Engineering-3/VAR-PBB/DC-DC.jpg

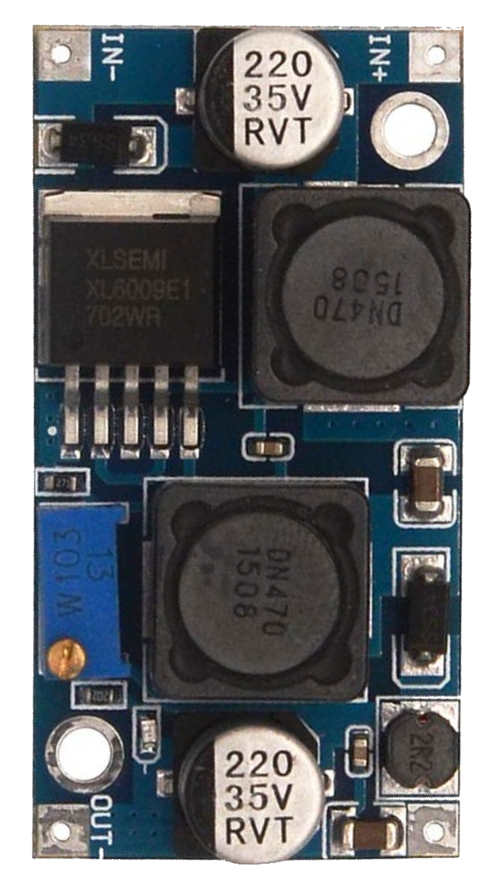
DC-DC.jpg
