Engineering-3/VAR-PBB/README.md

# VAR-PBB
Power Bus Board, but for variable uses
