Engineering-3/VAR-PBB/VAR-PBB_v02/README - VAR-PBB PCB Specification.txt

RCM-PBB-E1 PCB Specification
-------------------------------

BOARD STACK:

1. Copper Top
2. Copper Bottom

SILKSCREENS:

1.  Both Layers

PASTE MASKS:

1. Top Layer

BOARD MATERIALS:

RoHS Compliant: YES
Copper: 2oz  ************************************
Finish: Immersion Gold
Material: FR-406
Thickness: 62 mil
Tg>170
Soldermask: SMOBC BLUE
Silkscreen: White

BOARD TESTING:

Electrical Test: YES
