Engineering-3/VAR-PBB/VAR-PBB_v02/VAR-PBB_v02_render_top.png

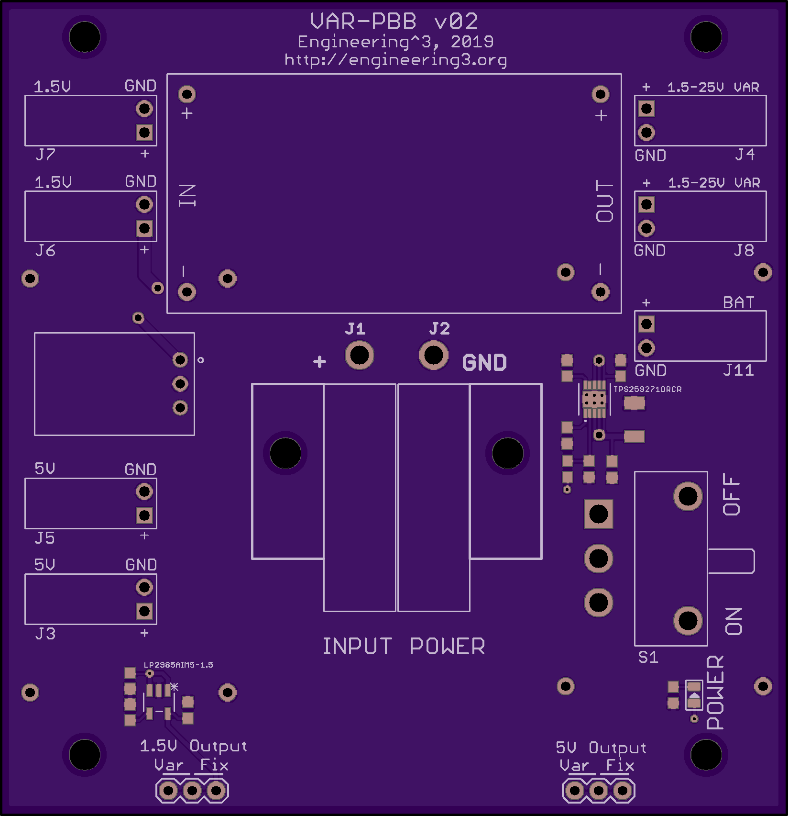
VAR-PBB_v02/VAR-PBB_v02_render_top.png
