Engineering-3/VAR-PBB/VAR-PBB_v02/VAR-PBB_v02_BOM.xlsx

Sheet: Bus Board RCM R05
VAR-PBB | Rev 02
Schmalz Haus LLC
Brian Schmalz - brian@schmalzhaus.com
Reference Designator | Value | MFR | MFR Part Number | Digikey Part Number | Qty | Description | Notes
U1 |  | Murata Power Solutions Inc. | OKI-78SR-5/1.5-W36H-C | 811-2692-ND | 1 | Linear Regulator Replacement DC DC Converter 1 Output 5V 1.5A 7V - 36V Input | 5V fixed DC-DC switching regulator, right angle style
U5 |  | Texas Instruments | LP2985AIM5-1.5/NOPB | LP2985AIM5-1.5/NOPBCT-ND | 1 | Linear Voltage Regulator IC 1 Output 150mA SOT-23-5 | 1.5V linear low dropout regulator, SOT-23-5
D2 |  | Visual Communications Company - VCC | CMD17-21SRC/TR8 | L62411CT-ND | 1 | Red LED Indication - Discrete 1.7V 0805 (2012 Metric) | Super bright red LED 0805
U6 |  | Texas Instruments | TPS259271DRCR | 296-44973-1-ND | 1 | Electronic Fuse Regulator 5A 10-VSON (3x3) | E-fuse, UVLO and over-current cutout
U2 |  | Amazon | XL6009 DC to DC |  | 1 |  | https://www.amazon.com/gp/product/B07NTXSJHB/ref=ppx_yo_dt_b_asin_title_o09_s00?ie=UTF8&psc=1
J1 |  | Anderson Power Products, Inc. | 1327 | 2243-1327-ND | 1 | 1 Position Blade Type Power Housing Connector Non-Gendered Red | Battery input power connector, RED
J2 |  | Anderson Power Products, Inc. | 1327G6-BK | 2243-1327G6-BK-ND | 1 | 1 Position Blade Type Power Housing Connector Non-Gendered Black | Battery input power connector, BLACK
 |  | Anderson Power Products, Inc. | 1399G8-BK | 2243-1399G8-BK-ND | 2 | PP10/45 MOUNTING WING BLUE | Power pole blue wings
 |  | Anderson Power Products, Inc. | 1377G4-BK | 2243-1377G4-BK-ND | 2 | Blade Contact Solder, PCB Non-Gendered Tin | Anderson power connector straight pins
S1 |  | E-Switch | 500SSP1S1M6QEA | EG2478-ND | 1 | Slide Switch SPDT Through Hole, Right Angle | Power slide switch
C6 |  | KEMET | C1210C226K4PACTU | 399-5092-1-ND | 1 | 22µF ±10% 16V Ceramic Capacitor X5R 1210 (3225 Metric) | 22uF 1210 16V ceramic cap
C2, C4, C5 |  | Murata Electronics | GRT188C8YA105KE13D | 490-12297-1-ND | 2 | 1µF ±10% 35V Ceramic Capacitor X6S 0603 (1608 Metric) | 1uF 0603 >30V ceramic cap
R3 |  | Stackpole Electronics Inc | RMCF0603FT45K3 | RMCF0603FT45K3CT-ND | 1 | 45.3 kOhms ±1% 0.1W, 1/10W Chip Resistor 0603 (1608 Metric) Automotive AEC-Q200 Thick Film | 45.3K 1% 0603 resistor
R5 |  | Stackpole Electronics Inc | RMCF0603FG1M00 | RMCF0603FG1M00CT-ND | 1 | 1 MOhms ±1% 0.1W, 1/10W Chip Resistor 0603 (1608 Metric) Automotive AEC-Q200 Thick Film | 1M 1% 0603 resistor
R6 |  | Stackpole Electronics Inc | RMCF0603FT210K | RMCF0603FT210KCT-ND | 1 | 210 kOhms ±1% 0.1W, 1/10W Chip Resistor 0603 (1608 Metric) Automotive AEC-Q200 Thick Film | 210K 1% 0603 resistor
R4 |  | Stackpole Electronics Inc | RNCP0603FTD392R | RNCP0603FTD392RCT-ND | 1 | 392 Ohms ±1% 0.125W, 1/8W Chip Resistor 0603 (1608 Metric) Anti-Sulfur, Moisture Resistant Thin Film | 392 ohm 0603 resistor
J11, J8, J4, J3, J5 J6, J7 |  | Molex | 70553-0036 | WM4924-ND | 7 | Connector Header Through Hole, Right Angle 2 position 0.100" (2.54mm) | 2-pin polarized power output connectors
C1 |  | KEMET | C0603C104M5RACTU | 399-7845-1-ND | 1 | 0.1µF ±20% 50V Ceramic Capacitor X7R 0603 (1608 Metric) | .1uF 0603 cap
C3 |  | Murata Electronics | GRM188R6YA225MA12D | 490-10486-1-ND | 1 | 2.2µF ±20% 35V Ceramic Capacitor X5R 0603 (1608 Metric) | 2.2uF 0603 cap
J9, J10 |  | Adam Tech | PH1-03-UA | 2057-PH1-03-UA-ND | 2 | Connector Header Through Hole 3 position 0.100" (2.54mm) | 3-pin 0.1" male headers
JMP1, JMP2 |  | Sullins Connector Solutions | SPC02SYAN | S9001-ND | 2 | 2 (1 x 2) Position Shunt Connector Black Closed Top 0.100" (2.54mm) Gold | 2-pin 0.1" jumper shorting blocks
DO NOT POPULATE
C7 |  |  |  |  |  |  | Unknown value 0603 ceramic cap
U3, U4 |  | Amazon | XL6009 DC to DC |  | 2 |  | https://www.amazon.com/gp/product/B07NTXSJHB/ref=ppx_yo_dt_b_asin_title_o09_s00?ie=UTF8&psc=1

Sheet: Sheet2
Partlist
Exported | from Bus_Board_RCM_R05.s | ch at 5/5/2012 10:58:37 | AM
EAGLE Ver | sion 5.11.0 Copyright (c | ) 1988-2010 CadSoft
Part | Value | Device | Package
R14 | 0 | RESISTOR | 805
R34 | 0 | RESISTOR | 805
R42 | 0 | RESISTOR | 805
R50 | 0 | RESISTOR | 805
R3 | 0.033 | R-US_R2010 | R2010
R26 | 0.033 | R-US_R2010 | R2010
R36 | 0.033 | R-US_R2010 | R2010
R44 | 0.033 | R-US_R2010 | R2010
R25 | 22 | RESISTOR | 805
R29 | 22 | RESISTOR | 805
R17 | 25 | RESISTOR | 805
R1 | 100 | RESISTOR | 805
R8 | 100 | RESISTOR | 805
R19 | 499 | RESISTOR | 805
C1 | 0.1u | CAP0805 | 805
C3 | 0.1u | CAP0805 | 805
C5 | 0.1u | CAP0805 | 805
C6 | 0.1u | CAP0805 | 805
C7 | 0.1u | CAP0805 | 805
C8 | 0.1u | CAP0805 | 805
C9 | 0.1u | CAP0805 | 805
C10 | 0.1u | CAP0805 | 805
C11 | 0.1u | CAP0805 | 805
C13 | 0.1u | CAP0805 | 805
C14 | 0.1u | CAP0805 | 805
C20 | 0.1u | CAP0805 | 805
C23 | 0.1u | CAP0805 | 805
C31 | 0.1u | CAP0805 | 805
C37 | 0.1u | CAP0805 | 805
C39 | 0.1u | CAP0805 | 805
C40 | 0.1u | CAP0805 | 805
C41 | 0.1u | CAP0805 | 805
C42 | 0.1u | CAP0805 | 805
C43 | 0.1u | CAP0805 | 805
C27 | 0.22u | CAP0805 | 805
C28 | 0.22u | CAP0805 | 805
C33 | 0.22u | CAP0805 | 805
C34 | 0.22u | CAP0805 | 805
C4 | 0.47u | CAP0805 | 805
R10 | 1.02k | RESISTOR | 805
R12 | 1.02k | RESISTOR | 805
R15 | 1.02k | RESISTOR | 805
R18 | 1.02k | RESISTOR | 805
R24 | 1.02k | RESISTOR | 805
R33 | 100k | RESISTOR | 805
R41 | 100k | RESISTOR | 805
R49 | 100k | RESISTOR | 805
R55 | 100k | RESISTOR | 805
R60 | 100k | RESISTOR | 805
R62 | 100k | RESISTOR | 805
R63 | 100k | RESISTOR | 805
R64 | 100k | RESISTOR | 805
R65 | 100k | RESISTOR | 805
R66 | 100k | RESISTOR | 805
R67 | 100k | RESISTOR | 805
R68 | 100k | RESISTOR | 805
R69 | 100k | RESISTOR | 805
R7 | 10k | RESISTOR | 805
R22 | 10k | RESISTOR | 805
R61 | 10k | RESISTOR | 805
R52 | 15k | RESISTOR | 805
R53 | 15k | RESISTOR | 805
R57 | 15k | RESISTOR | 805
R58 | 15k | RESISTOR | 805
U18 | 18F25K80 | PIC18F25K80 | SSOP28
R2 | 1k | RESISTOR | 805
R4 | 1k | RESISTOR | 805
R5 | 1k | RESISTOR | 805
R20 | 1k | RESISTOR | 805
R21 | 1k | RESISTOR | 805
R27 | 1k | RESISTOR | 805
R35 | 1k | RESISTOR | 805
R43 | 1k | RESISTOR | 805
R51 | 1k | RESISTOR | 805
D8 | 1N4148A | 1N4148A | SOD323
D10 | 1N4148A | 1N4148A | SOD323
D12 | 1N4148A | 1N4148A | SOD323
D14 | 1N4148A | 1N4148A | SOD323
C17 | 2200p | CAP0805 | 805
C21 | 2200p | CAP0805 | 805
C24 | 2200p | CAP0805 | 805
C12 | 22uF25V | C-USC1206 | C1206
C19 | 22uF25V | C-USC1206 | C1206
C22 | 22uF25V | C-USC1206 | C1206
C25 | 22uF25V | C-USC1206 | C1206
C29 | 22uF25V | C-USC1206 | C1206
C35 | 22uF25V | C-USC1206 | C1206
R54 | 316k | RESISTOR | 805
L1 | 4.7uH | IND4_7UH_WURTH_3_16A | IND4_7UH_WURTH
L2 | 4.7uH | IND4_7UH_WURTH_3_16A | IND4_7UH_WURTH
C30 | 47uF10V | C-USC1206 | C1206
C36 | 47uF10V | C-USC1206 | C1206
C38 | 47uF10V | C-USC1206 | C1206
R6 | 51k | RESISTOR | 805
R28 | 51k | RESISTOR | 805
R37 | 51k | RESISTOR | 805
R45 | 51k | RESISTOR | 805
R59 | 536k | RESISTOR | 805
R32 | 63.4k | RESISTOR | 805
R56 | 63.4k | RESISTOR | 805
C26 | 680p | CAP0805 | 805
C32 | 680p | CAP0805 | 805
U2 | 74LVC1G14DBV | 74LVC1G14DBV | SOT23-5
R9 | 9.09k | RESISTOR | 805
R11 | 9.09k | RESISTOR | 805
R13 | 9.09k | RESISTOR | 805
R16 | 9.09k | RESISTOR | 805
R23 | 9.09k | RESISTOR | 805
J1 | ANDERSON_POWER_POLE | ANDERSON_POWER_POLE | ANDERSON_POWER_POLE
J2 | ANDERSON_POWER_POLE | ANDERSON_POWER_POLE | ANDERSON_POWER_POLE
D6 | B340 | B340 | SMA_DO214AC
D7 | B340 | B340 | SMA_DO214AC
D2 | BAS16W | DIODE-SOD323-W | SOD323-W
D4 | BAS16W | DIODE-SOD323-W | SOD323-W
D5 | BAS16W | DIODE-SOD323-W | SOD323-W
D3 | BAS40-05 | BAS40-05 | SOT23
D9 | BZX384-C15 | BZX384-C15 | SOD323
D11 | BZX384-C15 | BZX384-C15 | SOD323
D13 | BZX384-C15 | BZX384-C15 | SOD323
D15 | BZX384-C15 | BZX384-C15 | SOD323
C2 | CAP_ELT_PANASONIC_100UF | CAP_ELT_PANASONIC_100UF | PANASONIC-D8-ELT-CAP
J5 | CON1X2_SHROUDED | CON1X2_SHROUDED | HEADER_1X2_SHROUDED
J6 | CON1X2_SHROUDED | CON1X2_SHROUDED | HEADER_1X2_SHROUDED
J7 | CON1X2_SHROUDED | CON1X2_SHROUDED | HEADER_1X2_SHROUDED
J3 | CON2X3 | CON2X3 | CON2X3
J4 | CON2X3 | CON2X3 | CON2X3
U16 | LT3680 | LT3680 | MSOP10
U17 | LT3680 | LT3680 | MSOP10
U4 | LTC1154 | LTC1154 | SOIC08
U11 | LTC1154 | LTC1154 | SOIC08
U13 | LTC1154 | LTC1154 | SOIC08
U15 | LTC1154 | LTC1154 | SOIC08
U1 | MC78L05ACHX | MC78L05ACHX | SOT89
C18 | OPEN | CAP0805 | 805
D1 | OPEN | DIODE-SOD323-W | SOD323-W
Q2 | SI7806ADN-T1-E3 | SI7806ADN-T1-E3 | 1212-8POWERPAK
Q3 | SI7806ADN-T1-E3 | SI7806ADN-T1-E3 | 1212-8POWERPAK
Q4 | SI7806ADN-T1-E3 | SI7806ADN-T1-E3 | 1212-8POWERPAK
Q5 | SI7806ADN-T1-E3 | SI7806ADN-T1-E3 | 1212-8POWERPAK
S1 | SWITCH_SLIDE_ON_ON | SWITCH_SLIDE_ON_ON | SWITCH_SLIDE_RA
U8 | TPS2024 | TPS2024 | SOIC08
J8 |  | M05PTH | 1X05
J9 |  | M03PTH | 1X03
LED1 |  | LEDCHIPLED_0805 | CHIPLED_0805
LED2 |  | LEDCHIPLED_0805 | CHIPLED_0805
LED3 |  | LEDCHIPLED_0805 | CHIPLED_0805
LED4 |  | LEDCHIPLED_0805 | CHIPLED_0805
LED5 |  | LEDCHIPLED_0805 | CHIPLED_0805
LED6 |  | LEDCHIPLED_0805 | CHIPLED_0805
LED7 |  | LEDCHIPLED_0805 | CHIPLED_0805
LED8 |  | LEDCHIPLED_0805 | CHIPLED_0805
