Engineering-3/VAR-PBB/VAR-PBB_v02/VAR-PBB_v02_sch.pdf

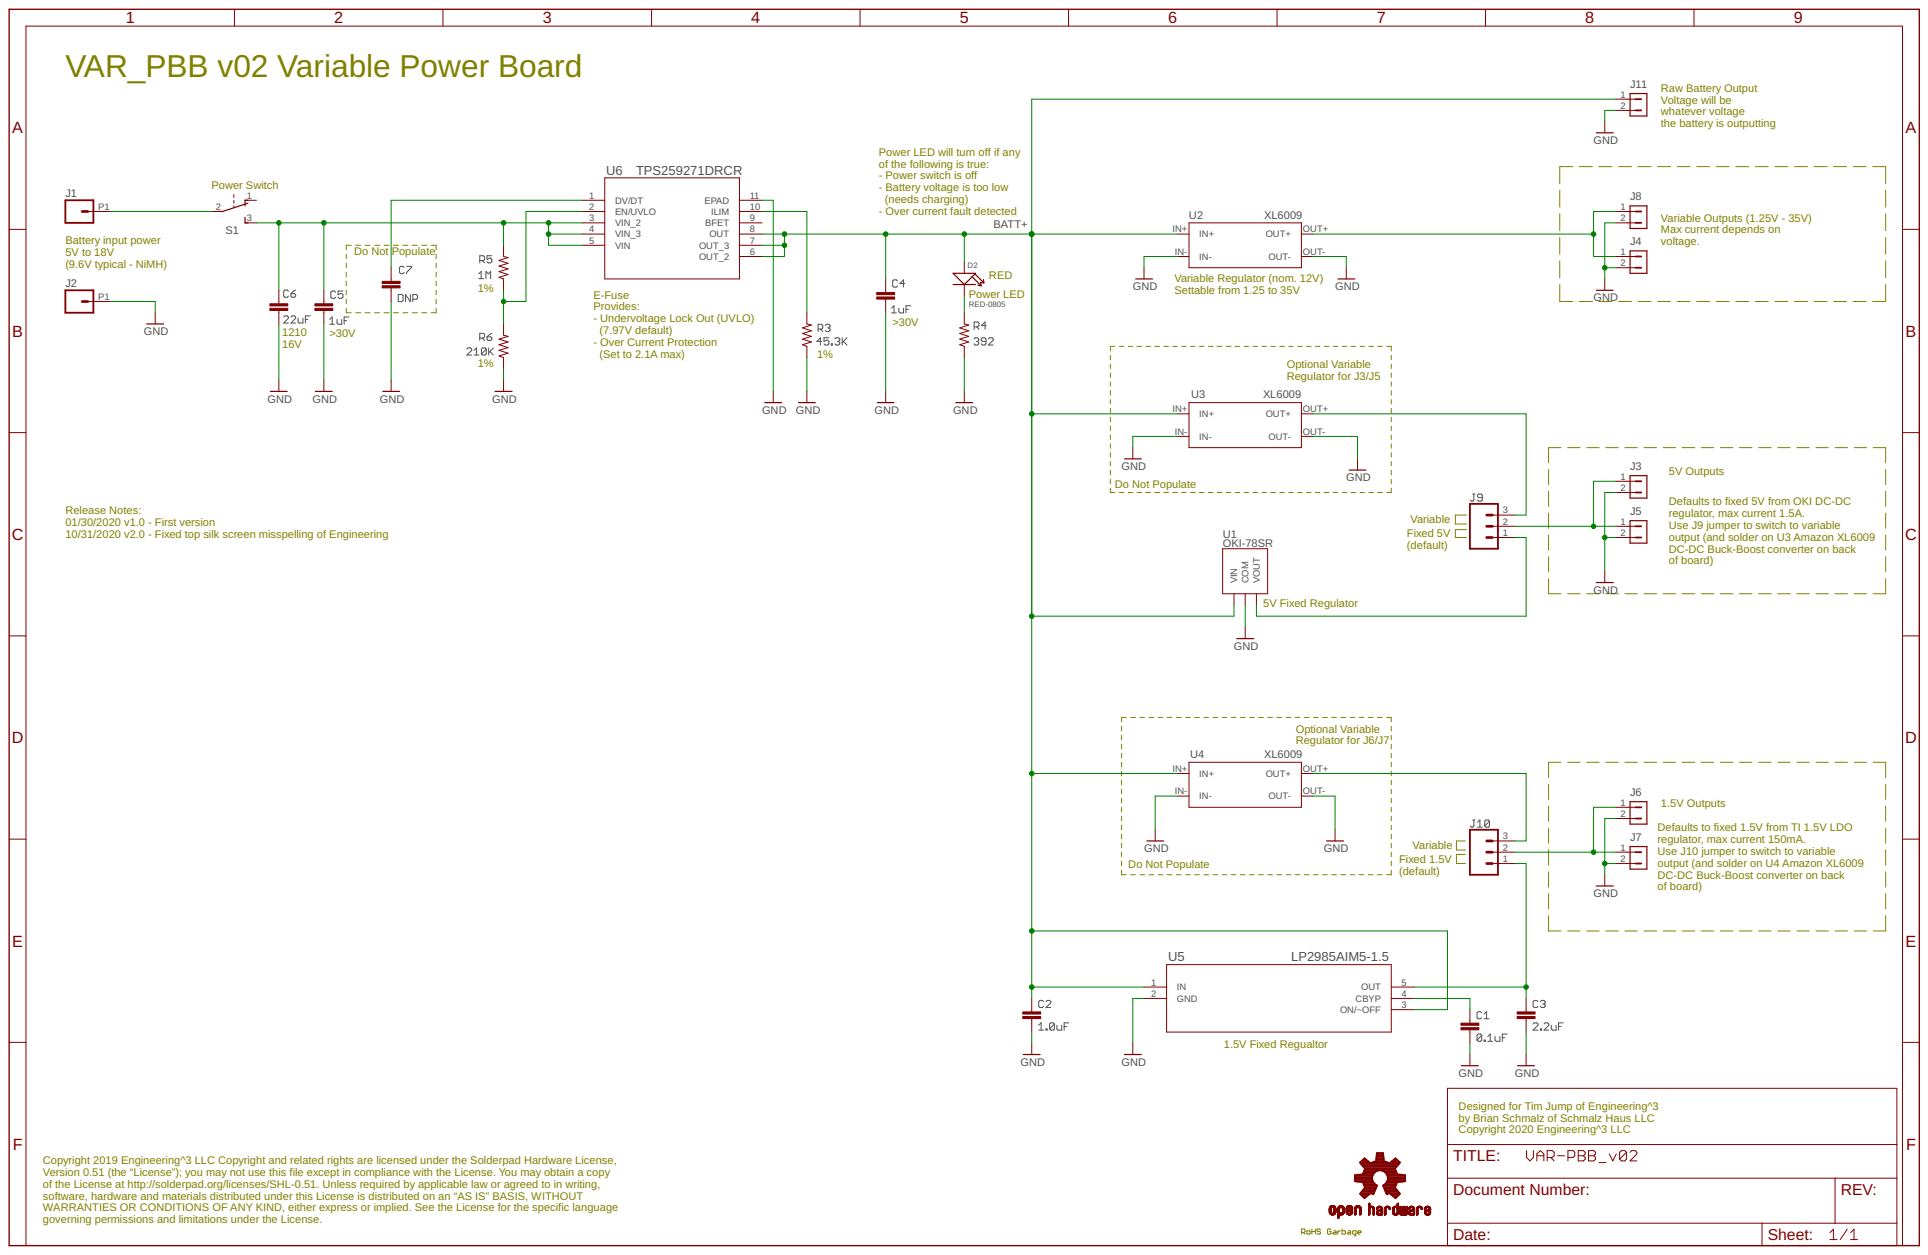
[picture p4: page 1]

Raw Battery Output Voltage will be whatever voltage

the battery is outputting

Variable Outputs (1.25V - 35V) Max current depends on

Battery input power 5V to 18V

Variable Regulator (nom. 12V) Settable from 1.25 to 35V

Optional Variable Regulator for J3/J5

Release Notes: 01/30/2020 v1.0 - First version

regulator, max current 1.5A. Use J9 jumper to switch to variable

10/31/2020 v2.0 - Fixed top silk screen misspelling of Engineering

output (and solder on U3 Amazon XL6009 DC-DC Buck-Boost converter on back of board)

Optional Variable Regulator for J6/J7

Defaults to fixed 1.5V from TI 1.5V LDO
regulator, max current 150mA. Use J10 jumper to switch to variable

output (and solder on U4 Amazon XL6009 DC-DC Buck-Boost converter on back of board)

Designed for Tim Jump of Engineering^3
by Brian Schmalz of Schmalz Haus LLC
Copyright 2020 Engineering^3 LLC

Copyright 2019 Engineering^3 LLC Copyright and related rights are licensed under the Solderpad Hardware License, Version 0.51 (the “License”); you may not use this file except in compliance with the License. You may obtain a copy of the License at http://solderpad.org/licenses/SHL-0.51. Unless required by applicable law or agreed to in writing, software, hardware and materials distributed under this License is distributed on an “AS IS” BASIS, WITHOUT WARRANTIES OR CONDITIONS OF ANY KIND, either express or implied. See the License for the specific language

governing permissions and limitations under the License.
