Engineering-3/VAR-PBB/VAR-PBB_v02/VAR-PBB_v02_brd.pdf

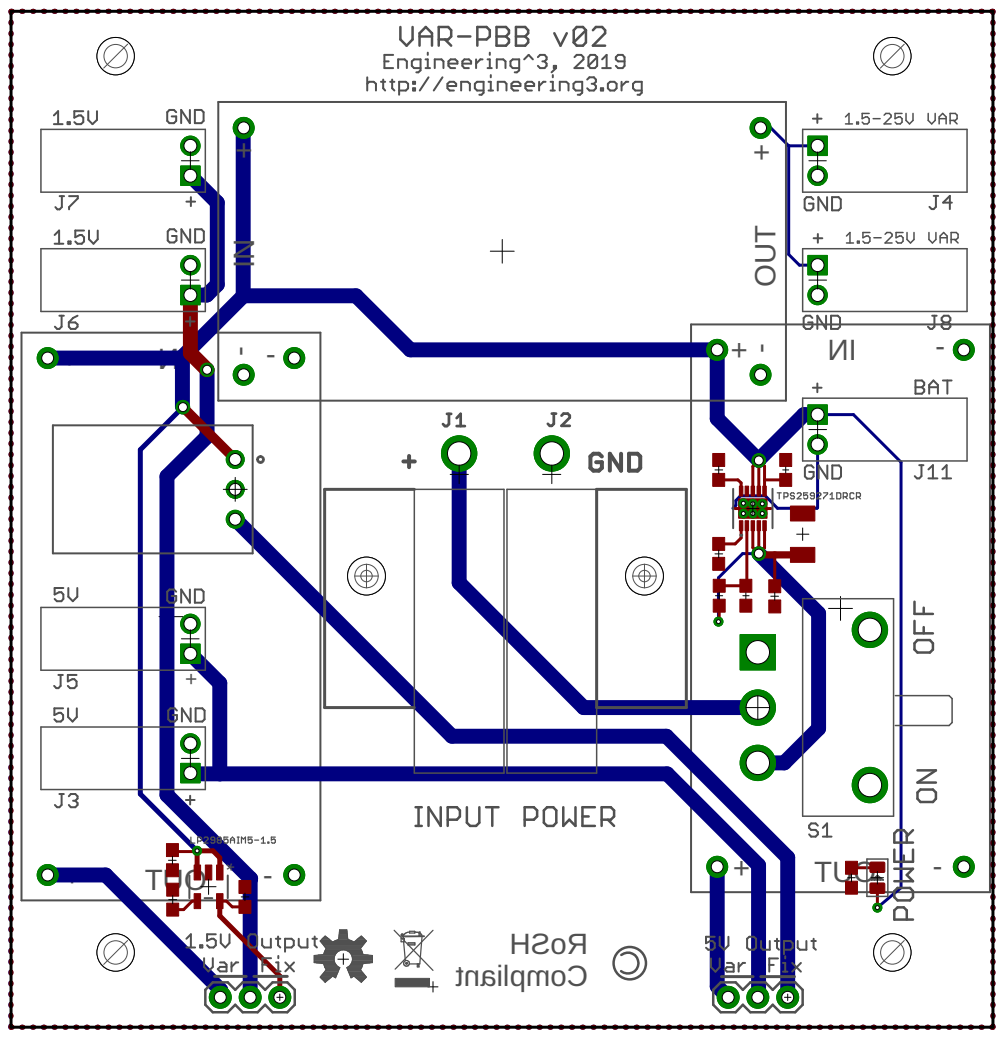
[picture p5: page 1]
