Engineering-3/VAR-PBB/VAR-PBB_v01/VAR-PBB_v01_brd.pdf

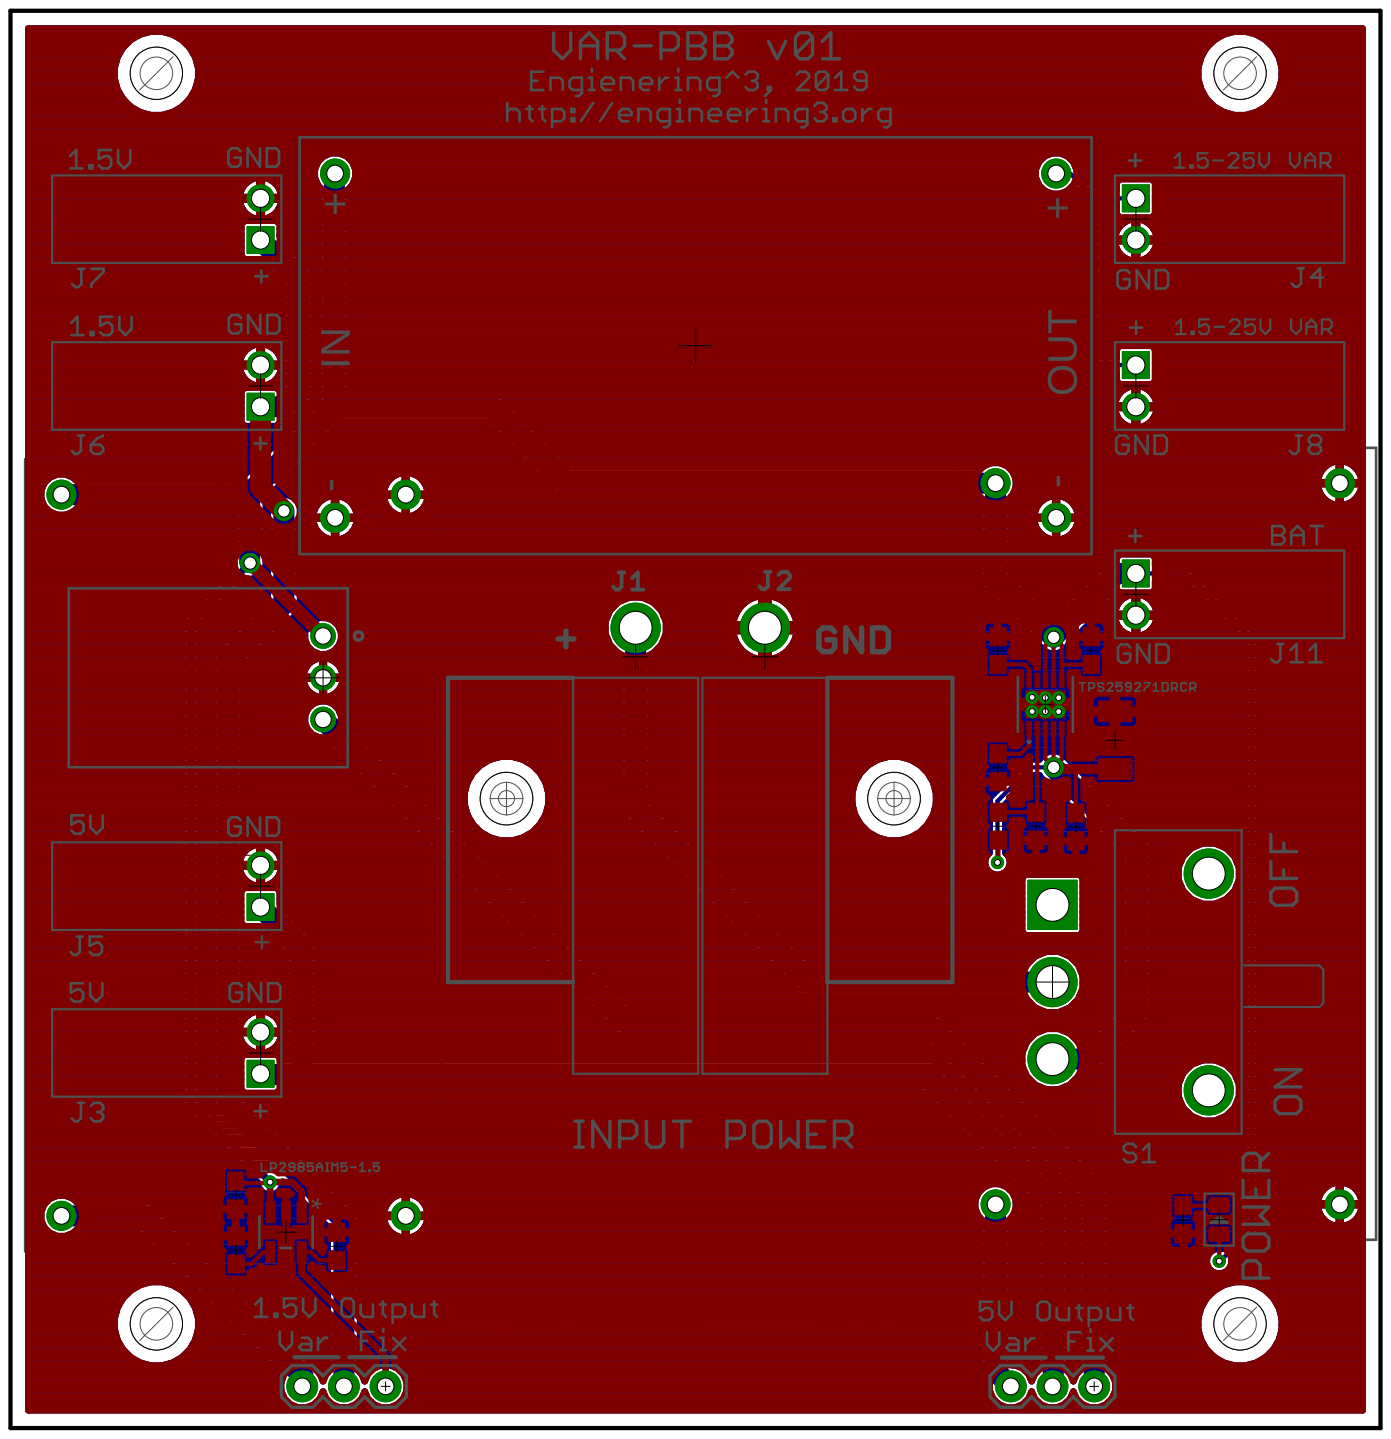
[picture p6: page 1]
