Engineering-3/VAR-PBB/VAR-PBB_v02/VAR-PBB_v02.brd

## EAGLE design VAR-PBB_v02/VAR-PBB_v02.brd (2020-10-31)

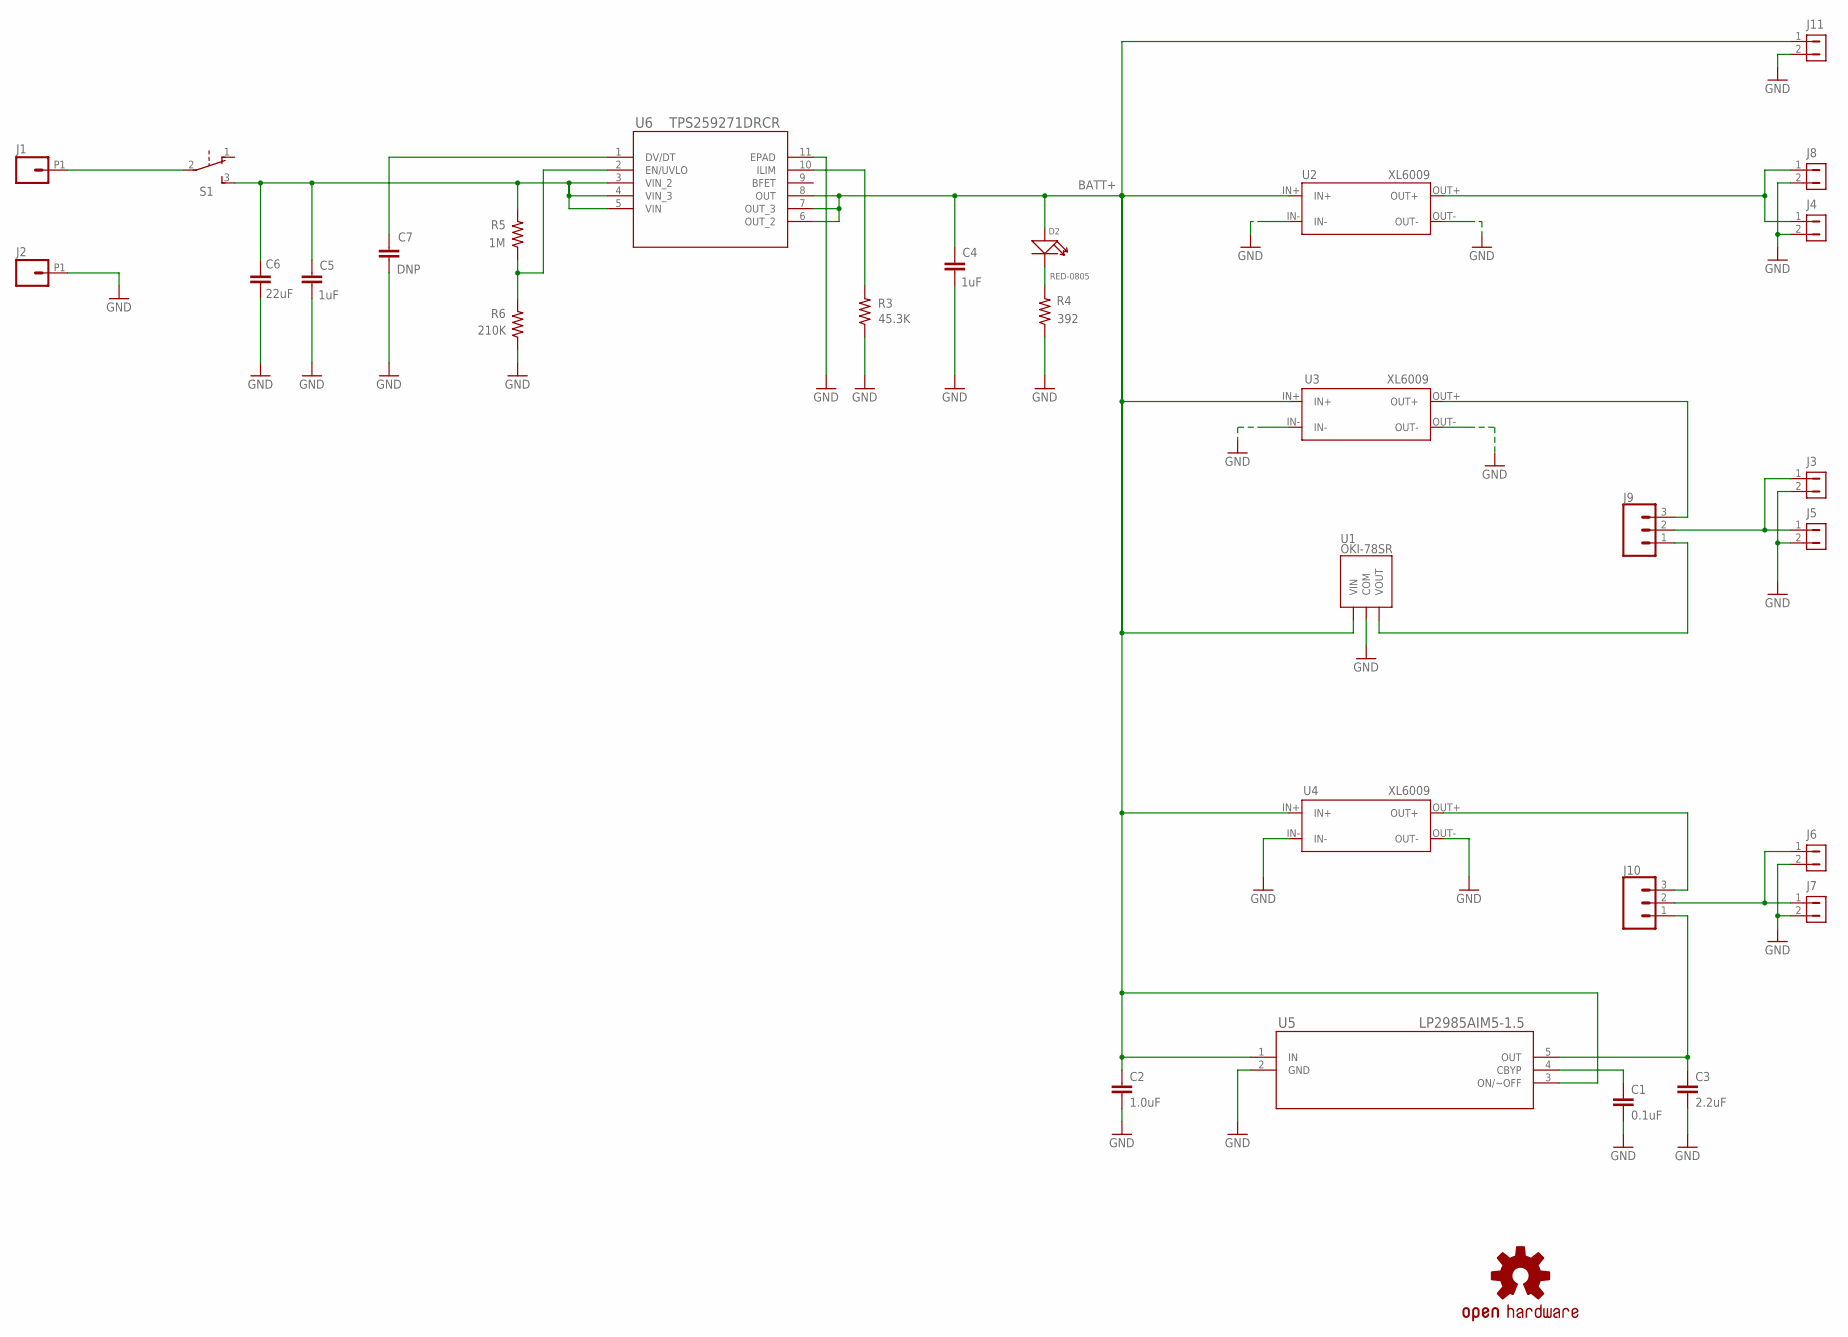
[picture p7: schematic VAR-PBB_v02.sch]

Parts:
C1: 0.1uF; 0603
C2: 1.0uF; 0603
C3: 2.2uF; 0603
C4, C5: 1uF; 0603
C6: 22uF; 1210
C7: DNP; 0603
D2: RED-0805; LED-0805
J1, J2: ANDERSON_POWER_POLE
J3, J4, J5, J6, J7, J8, J11: CON1X2_SHROUDED; HEADER_1X2_SHROUDED
J9, J10: CONN_03; 1X03
LOGO2: OSHW-LOGOM; OSHW-LOGO-M
R3: 45.3K; 0603
R4: 392; 0603
R5: 1M; 0603
R6: 210K; 0603
S1: SWITCH_SLIDE_ON_ON; SWITCH_SLIDE_RA
U1: OKI-78SR; OKI-78SR_REGULATOR_HORIZONTAL
U2, U3, U4: XL6009; XL6009_MODULE
U5: LP2985AIM5-1.5; MF05A
U6: TPS259271DRCR; DRC10_1P65X2P40
U$6: ROHS_GARBAGE; ROHS_GARBAGE_5MM

Connections:
1.5V_REG: C3.1, J10.1, U5.5 (OUT)
5V_REG: J9.1, U1.P$3 (VOUT)
BATT+: C2.1, C4.2, D2.+, J11.1, U1.P$1 (VIN), U2.IN+, U3.IN+, U4.IN+, U5.1 (IN), U5.3 (ON/~OFF), U6.6 (OUT_2), U6.7 (OUT_3), U6.8 (OUT)
CHANNEL3: J3.1, J5.1, J9.2
CHANNEL4: J6.1, J7.1, J10.2
GND: C1.2, C2.2, C3.2, C4.1, C5.1, C6.2, C7.1, J2.P1, J3.2, J4.2, J5.2, J6.2, J7.2, J8.2, J11.2, R3.1, R4.1, R6.1, U1.P$2 (COM), U2.IN-, U2.OUT-, U3.IN-, U3.OUT-, U4.IN-, U4.OUT-, U5.2 (GND), U6.11 (EPAD)
unnamed: C5.2, C6.1, R5.2, S1.3 (S), U6.3 (VIN_2), U6.4 (VIN_3), U6.5 (VIN)
unnamed: D2.-, R4.2
unnamed: J9.3, U3.OUT+
unnamed: R5.1, R6.2, U6.2 (EN/UVLO)
unnamed: J4.1, J8.1, U2.OUT+
unnamed: J10.3, U4.OUT+
unnamed: C1.1, U5.4 (CBYP)
unnamed: J1.P1, S1.2
unnamed: R3.2, U6.10 (ILIM)
unnamed: C7.2, U6.1 (DV/DT)

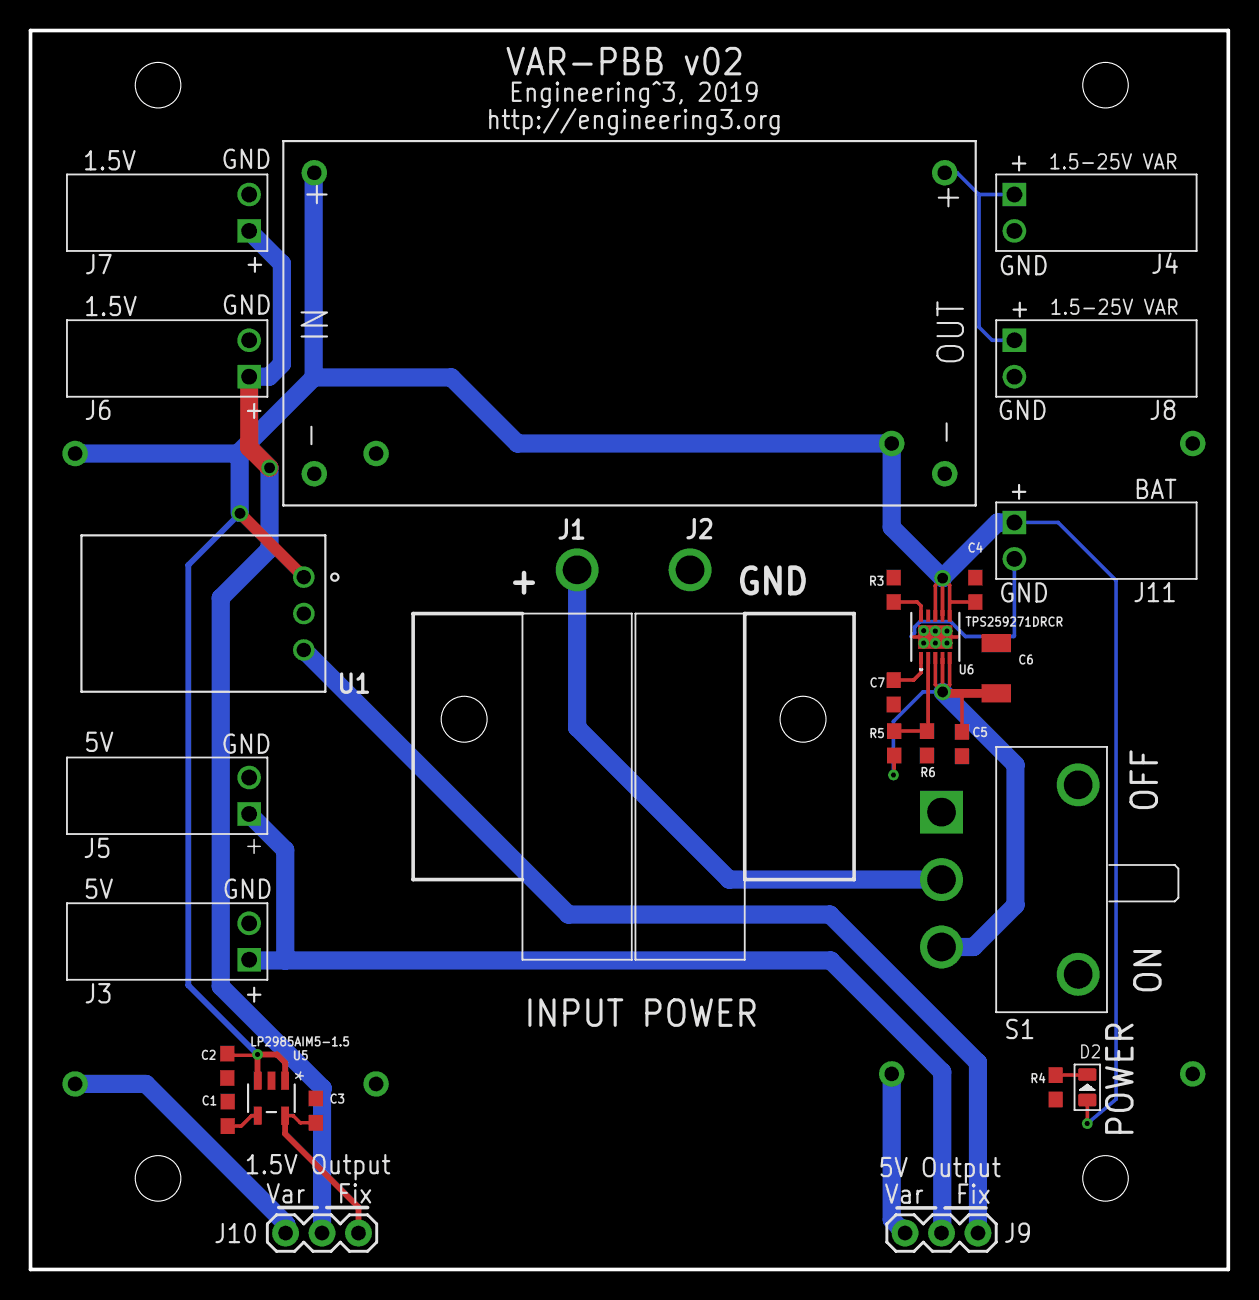
[picture p8: board VAR-PBB_v02.brd from above]

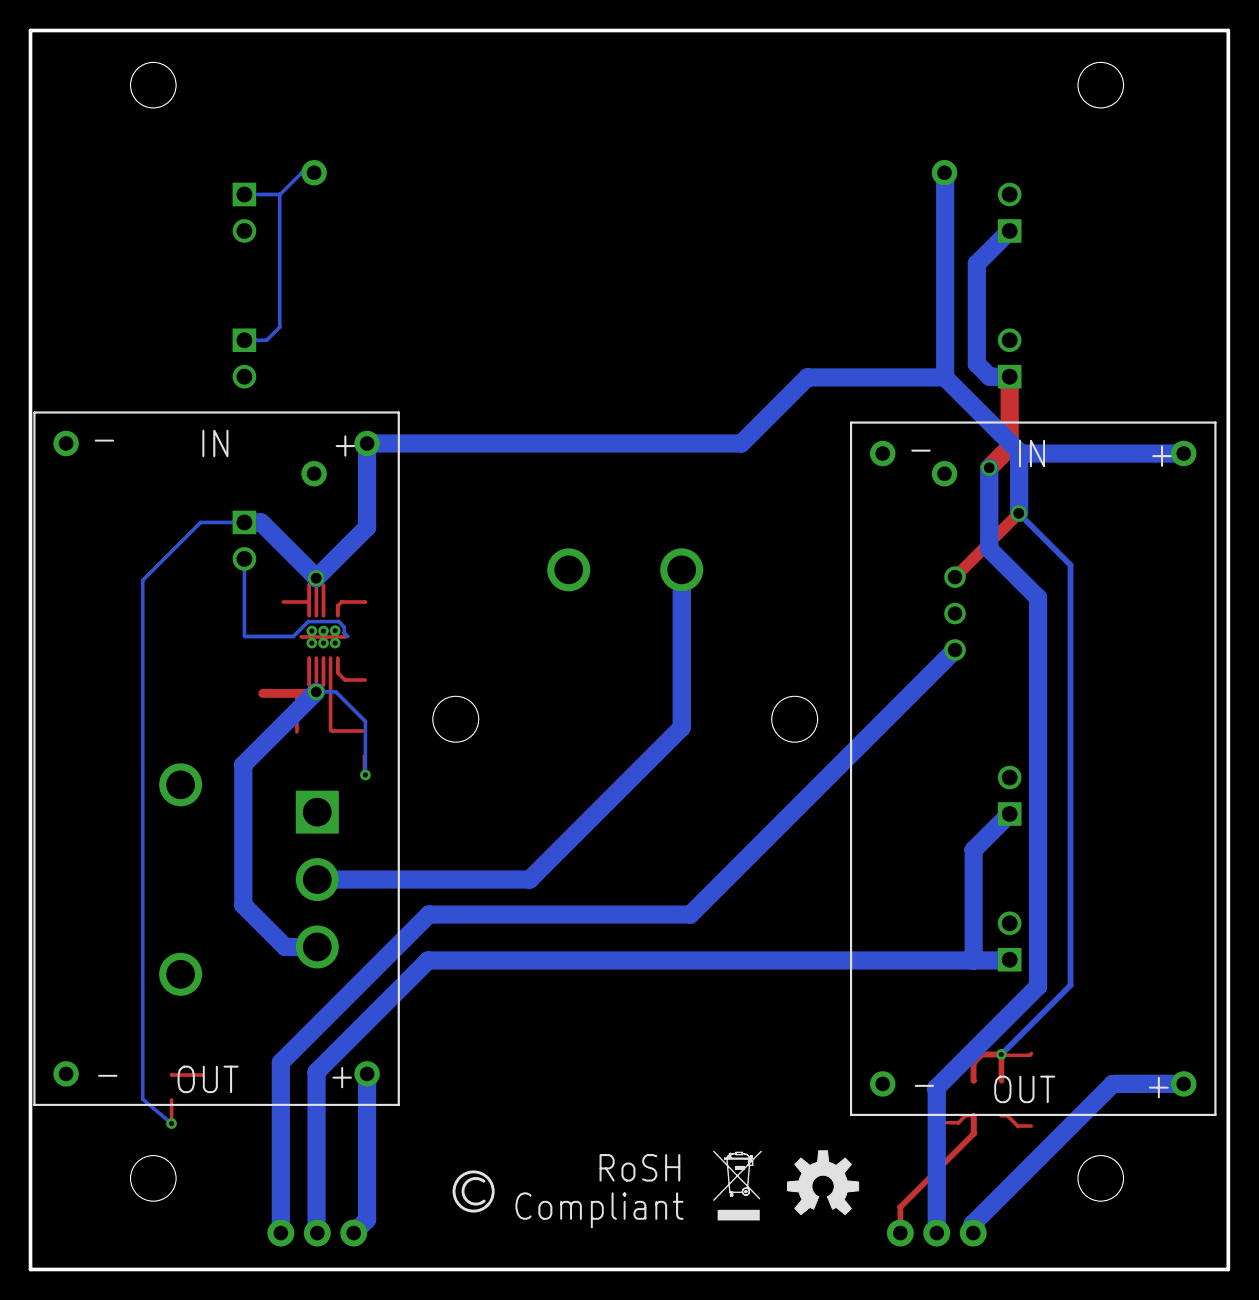
[picture p9: board VAR-PBB_v02.brd from below]

Board: 2 copper layers, 83.5 x 86.4 mm, 32 parts (4 on the bottom side), 16 nets.
