Engineering-3/VAR-PBB/(commit log)

2019-12-28 First checkin. WIP.
    [VAR-PBB_v01.brd, VAR-PBB_v01.sch, VAR-PBB_v01.xlsx]
2019-12-30 WIP, but got a ton done.
    [VAR-PBB_v01.brd, VAR-PBB_v01.sch]
2019-12-31 Got all of the features in, board layout done, silk screen tweaked. Need to pick resistor values for UVLO and dV/dT, power LED, and finish BOM xls.
    [VAR-PBB_v01.brd, VAR-PBB_v01.sch]
2020-01-02 v01 done - schematic complete and cleaned up, board fully routed, passes DRC, BOM complete.
    [VAR-PBB_v01.brd, VAR-PBB_v01.sch, VAR-PBB_v01.xlsx, VAR-PBB_v01_BOM.xlsx]
2020-01-31 Latest version of VAR-PBB, as built. Updated under voltage cutout resistor to get UVLO to around 8.1 V.
    [VAR-PBB_v01.brd, VAR-PBB_v01.sch, VAR-PBB_v01_BOM.xlsx]
2020-10-31 Fixed misspelled top silk text "Engineering" to create v2.0 design.
    [VAR-PBB_v02.brd, VAR-PBB_v02.sch, VAR-PBB_v02_BOM.xlsx]
