Engineering-3/VAR-PBB/(notices)

Notices in the files:
parts and their libraries:
SparkFun-Aesthetics: Licensing: Creative Commons ShareAlike 4.0 International - https://creativecommons.org/licenses/by-sa/4.0
COPYRIGHT: Copyright (C) 2018 Accelerated Designs. All rights reserved
